ChooDH/DKRoA/연구자료/DKRoA 그림/DKRoA_구조.png

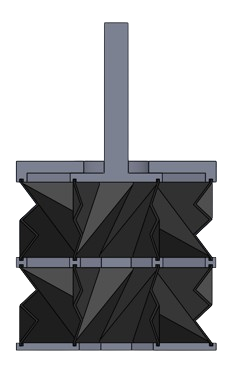
연구자료/DKRoA 그림/DKRoA_구조.png
