ChooDH/DKRoA/연구자료/DKRoA 그림/Inner_DKRoA.png

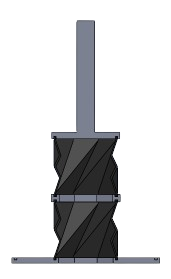
연구자료/DKRoA 그림/Inner_DKRoA.png
