ChooDH/DKRoA/연구자료/DKRoA 그림/Kresling_pattern.png

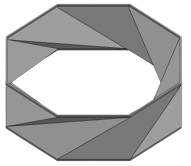
연구자료/DKRoA 그림/Kresling_pattern.png
