ChooDH/DKRoA/연구자료/DKRoA 그림/Kresling_pattern_folding.png

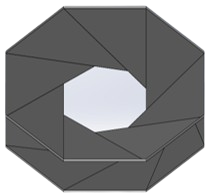
연구자료/DKRoA 그림/Kresling_pattern_folding.png
