ChooDH/DKRoA/연구자료/DKRoA 그림/Outer_DKRoA.png

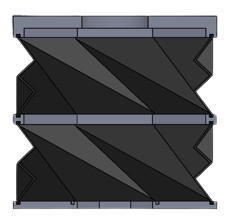
연구자료/DKRoA 그림/Outer_DKRoA.png
