ChooDH/DKRoA/연구자료/DKRoA 그림/그림7-removebg-preview.png

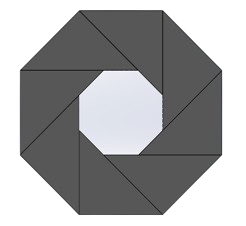
연구자료/DKRoA 그림/그림7-removebg-preview.png
