ChooDH/DKRoA/actuator_modeling/mechanical_seal/mechanical_seal_DKRoA.SLDASM

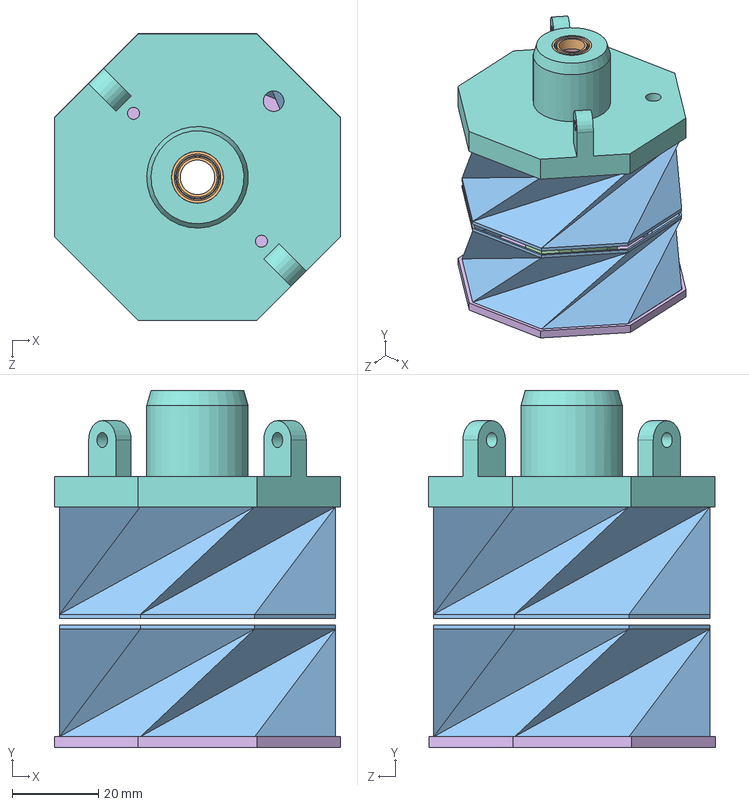
[picture p8: CAD file, 2024-12-23]
actuator_modeling/mechanical_seal/mechanical_seal_DKRoA.SLDASM
66.5 x 82.9 x 66.6 mm
outer_top_상판
outer_top_하판
bottom
MS_CeramicRing
inner_kresling_cw x 2
outer_kresling_cw x 2
bearing
spring
