ChooDH/DKRoA/actuator_modeling/magnetic_coupling/magnetic_10mm_3mm.SLDPRT

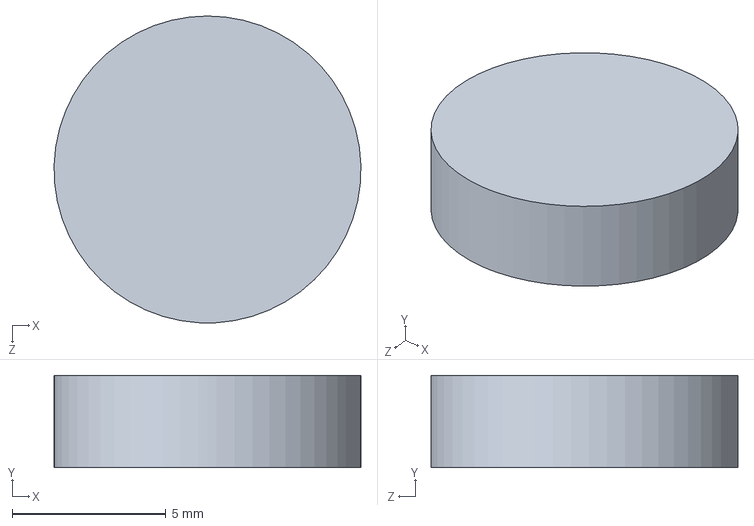
[picture p9: CAD file, 2024-12-23]
actuator_modeling/magnetic_coupling/magnetic_10mm_3mm.SLDPRT
10.00 x 3.00 x 10.0 mm
