ChooDH/DKRoA/actuator_modeling/opposite_direction/inner_top_opposite_direction.SLDPRT

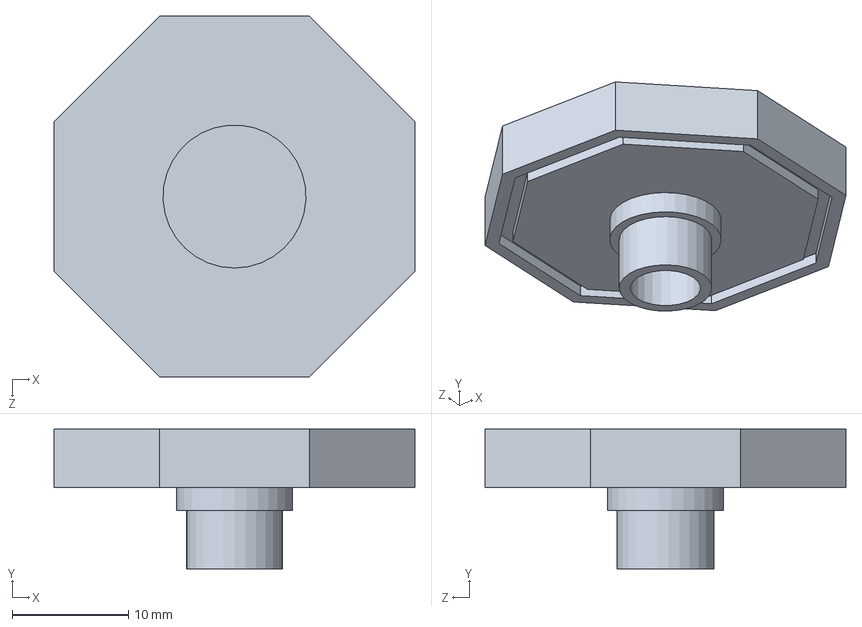
[picture p10: CAD file, 2024-12-23]
actuator_modeling/opposite_direction/inner_top_opposite_direction.SLDPRT
31.0 x 12.0 x 31.0 mm
