ChooDH/DKRoA/kresling_test/kresling test/kresling.SLDPRT

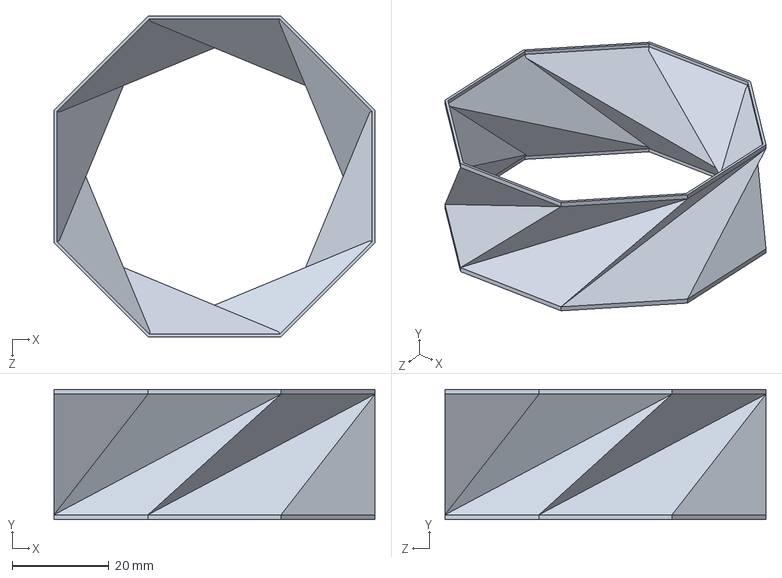
[picture p11: CAD file, 2024-12-23]
kresling_test/kresling test/kresling.SLDPRT
66.5 x 27.0 x 66.5 mm
