ChooDH/DKRoA/kresling_test/kresling test/test_stl/mode_test/kresling_mode_2_R_25_d_0.8.STL

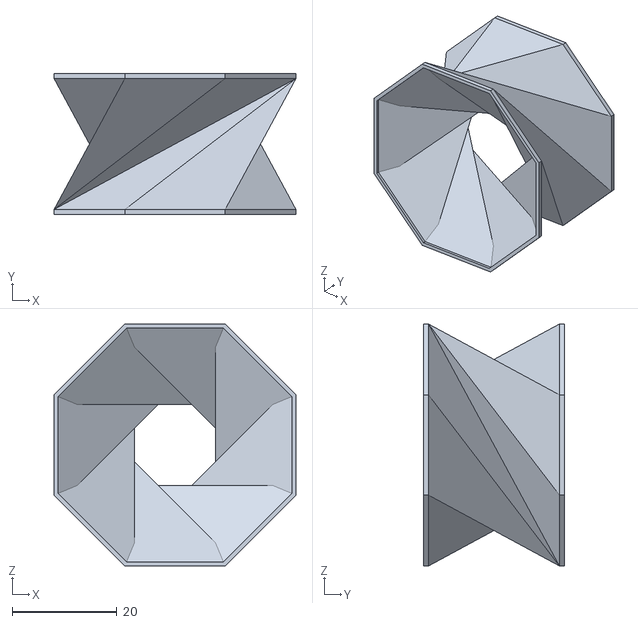
[picture p13: CAD file, 2024-12-23]
kresling_test/kresling test/test_stl/mode_test/kresling_mode_2_R_25_d_0.8.STL
46.2 x 27.0 x 46.2
