ChooDH/DKRoA/kresling_test/kresling test/test_stl/n_test/degree_test_top_n_6.STL

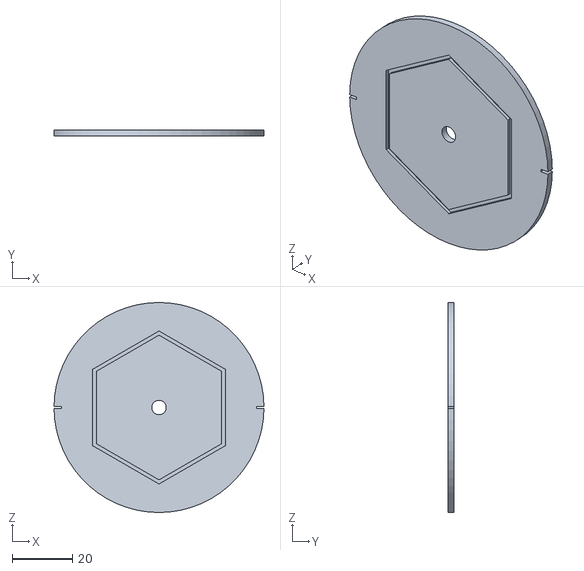
[picture p14: CAD file, 2024-12-23]
kresling_test/kresling test/test_stl/n_test/degree_test_top_n_6.STL
70.0 x 2.00 x 70.0
