ChooDH/DKRoA/kresling_test/kresling test/test_stl/outer_kresling_cw_71mm.STL

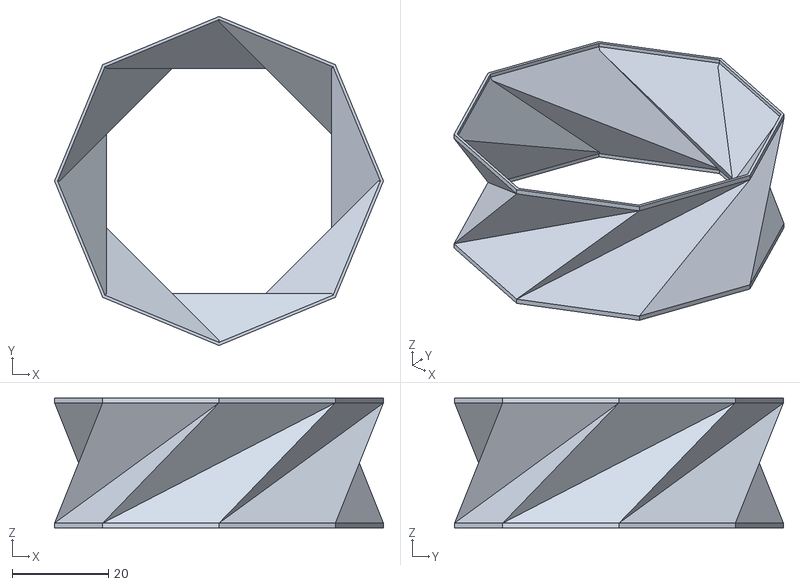
[picture p15: CAD file, 2024-12-23]
kresling_test/kresling test/test_stl/outer_kresling_cw_71mm.STL
68.4 x 68.4 x 27.0
