ChooDH/DKRoA/actuator_modeling/magnetic_coupling/inner_link_magnetic_coupling.SLDPRT

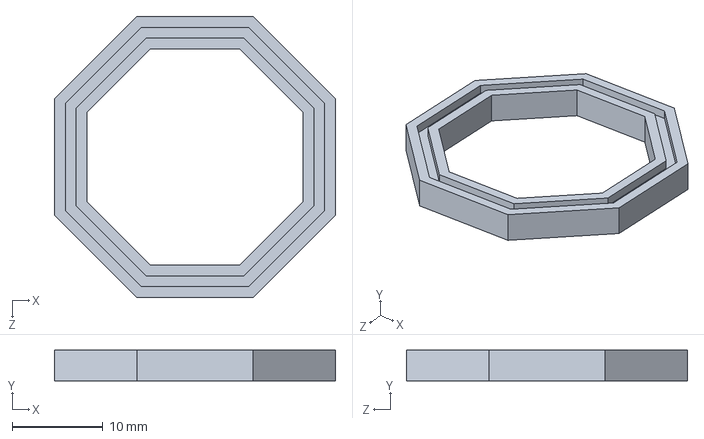
[picture p16: CAD file, 2024-12-23]
actuator_modeling/magnetic_coupling/inner_link_magnetic_coupling.SLDPRT
31.0 x 3.40 x 31.0 mm
