ChooDH/DKRoA/actuator_modeling/mechanical_seal/spring.SLDPRT

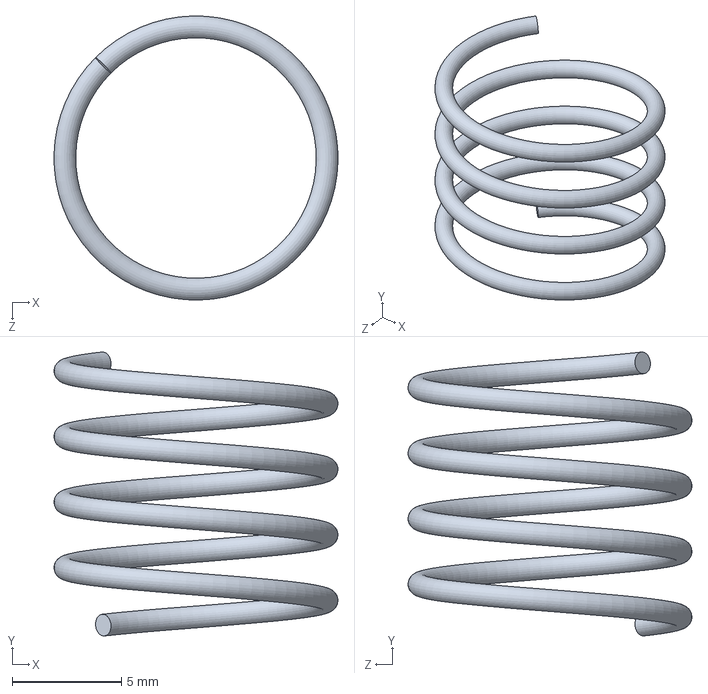
[picture p17: CAD file, 2024-12-23]
actuator_modeling/mechanical_seal/spring.SLDPRT
13.0 x 13.0 x 13.0 mm
