ChooDH/DKRoA/actuator_modeling/opposite_direction/plus_link_opposite_direction.SLDPRT

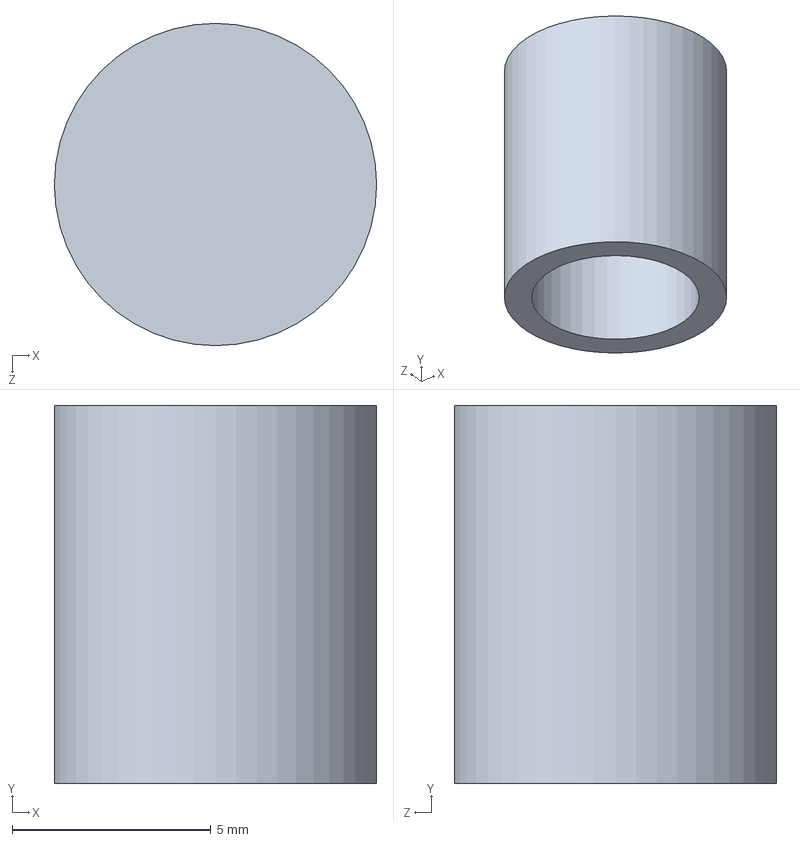
[picture p18: CAD file, 2024-12-23]
actuator_modeling/opposite_direction/plus_link_opposite_direction.SLDPRT
8.10 x 9.50 x 8.10 mm
