ChooDH/DKRoA/kresling_test/kresling test/degree_test_top.SLDPRT

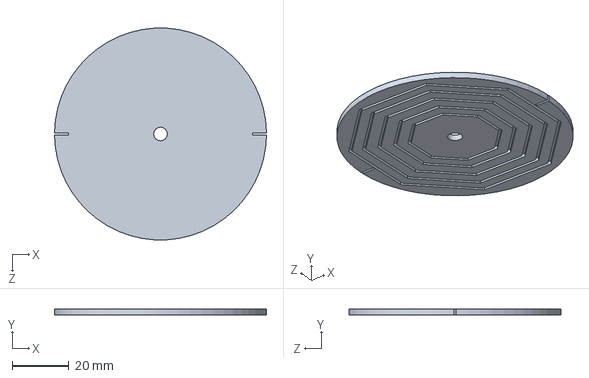
[picture p19: CAD file, 2024-12-23]
kresling_test/kresling test/degree_test_top.SLDPRT
75.0 x 2.00 x 74.9 mm
