ChooDH/DKRoA/kresling_test/kresling test/test_stl/D_test/kresling_R_20.STL

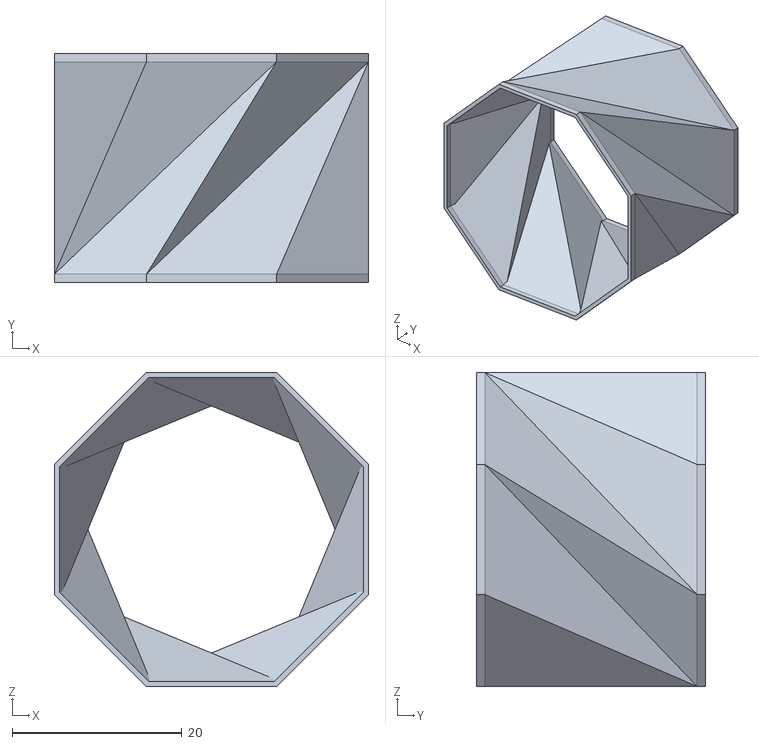
[picture p20: CAD file, 2024-12-23]
kresling_test/kresling test/test_stl/D_test/kresling_R_20.STL
37.0 x 27.0 x 37.0
