ChooDH/DKRoA/kresling_test/kresling test/test_stl/degree_test_top_2.STL

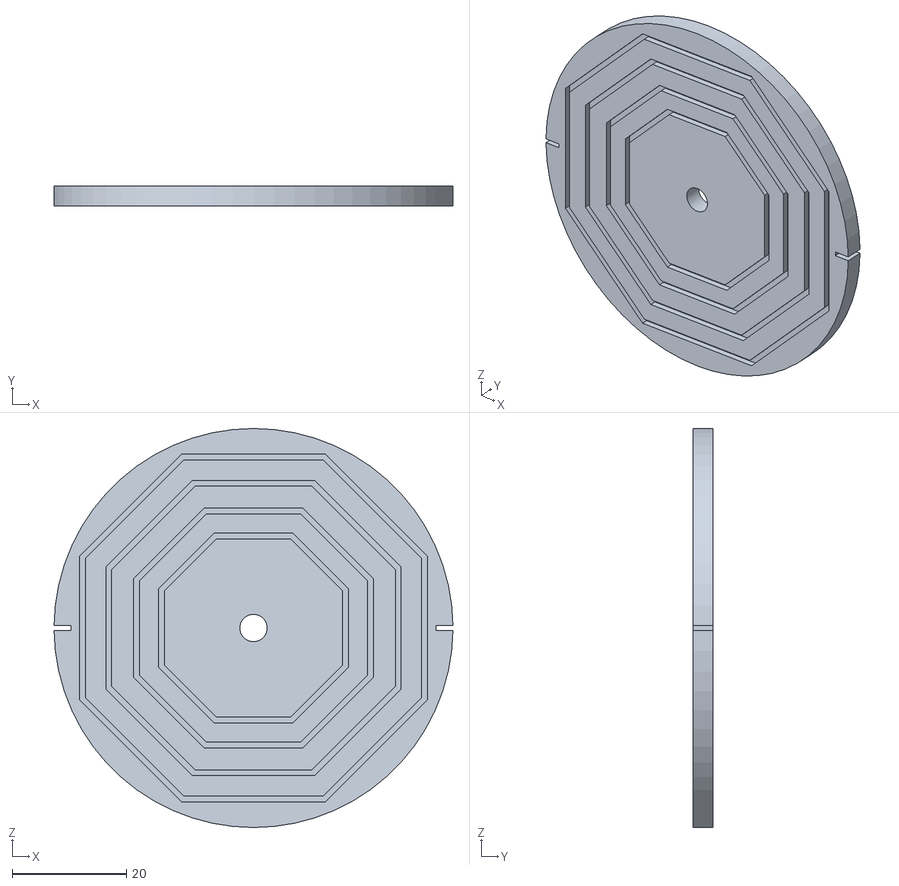
[picture p21: CAD file, 2024-12-23]
kresling_test/kresling test/test_stl/degree_test_top_2.STL
70.0 x 3.50 x 70.0
