ChooDH/DKRoA/kresling_test/kresling test/test_stl/mode_test/kresling_mode_2_R_30_d_1.STL

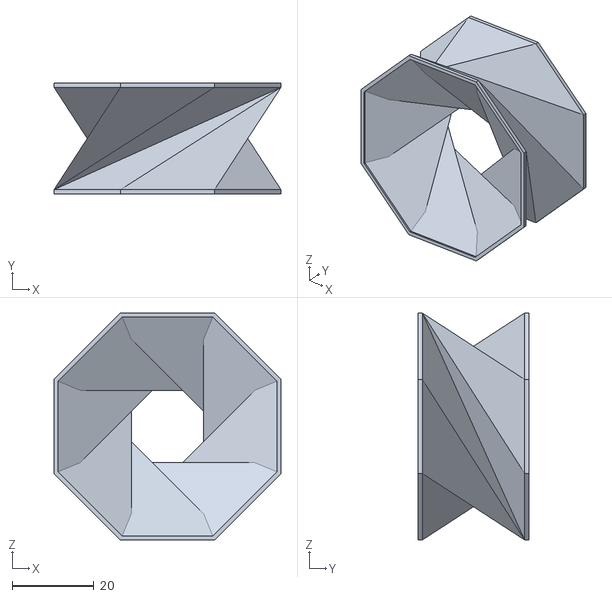
[picture p22: CAD file, 2024-12-23]
kresling_test/kresling test/test_stl/mode_test/kresling_mode_2_R_30_d_1.STL
55.4 x 27.0 x 55.4
