ChooDH/DKRoA/actuator_modeling/magnetic_coupling/bottom_magnetic_coupling.SLDPRT

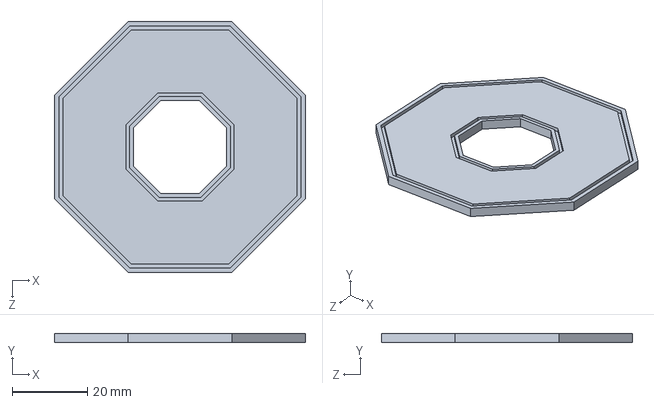
[picture p23: CAD file, 2024-12-23]
actuator_modeling/magnetic_coupling/bottom_magnetic_coupling.SLDPRT
66.5 x 2.50 x 66.5 mm
