ChooDH/DKRoA/actuator_modeling/mechanical_seal/outer_top_하판.SLDPRT

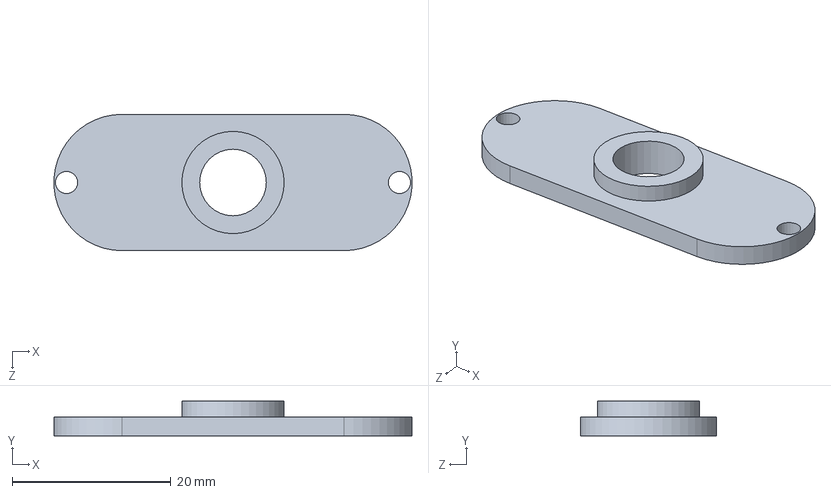
[picture p24: CAD file, 2024-12-23]
actuator_modeling/mechanical_seal/outer_top_하판.SLDPRT
45.2 x 4.40 x 17.2 mm
