ChooDH/DKRoA/actuator_modeling/opposite_direction/bottom_opposite_direction.SLDPRT

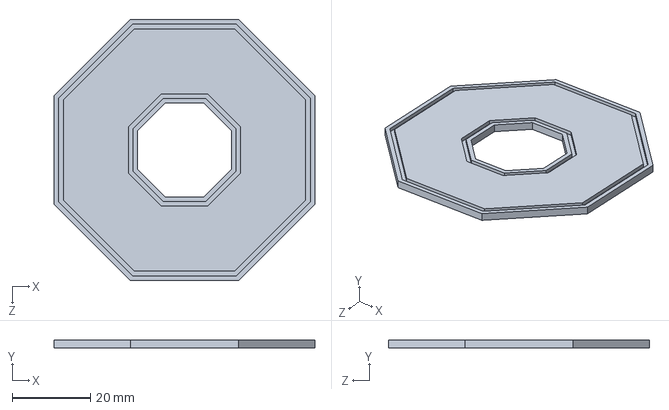
[picture p25: CAD file, 2024-12-23]
actuator_modeling/opposite_direction/bottom_opposite_direction.SLDPRT
66.5 x 2.00 x 66.5 mm
