ChooDH/DKRoA/kresling_test/kresling test/kresling_n__12_mode_4.SLDPRT

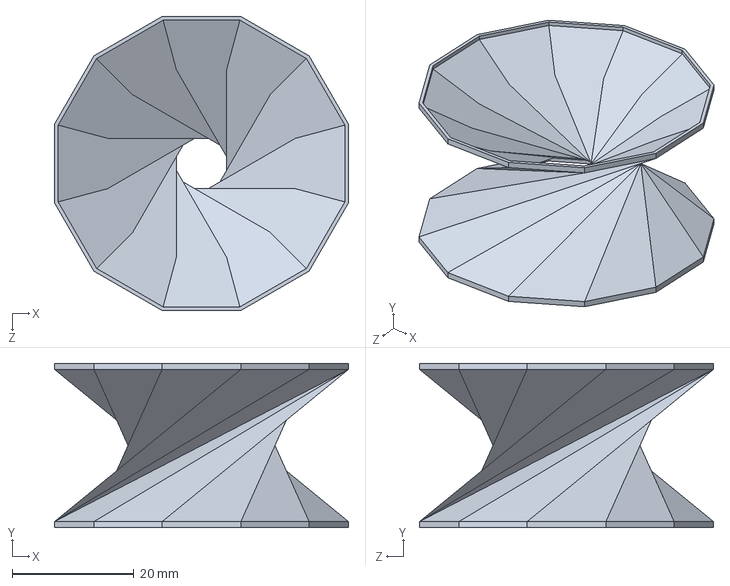
[picture p26: CAD file, 2024-12-23]
kresling_test/kresling test/kresling_n__12_mode_4.SLDPRT
48.3 x 27.0 x 48.3 mm
