ChooDH/DKRoA/kresling_test/kresling test/test_stl/D_test/kresling_R_25.STL

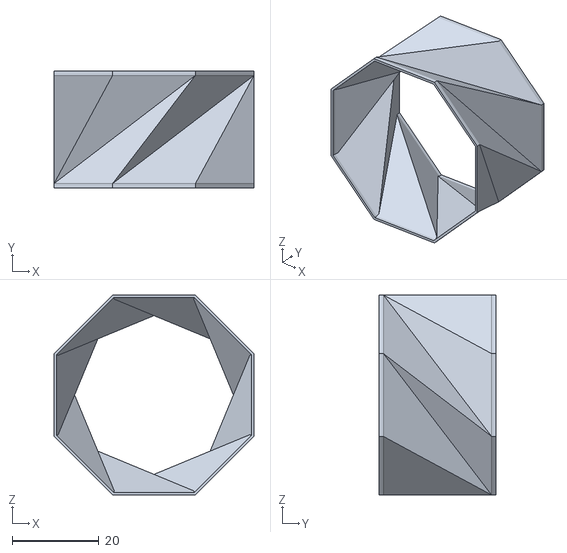
[picture p27: CAD file, 2024-12-23]
kresling_test/kresling test/test_stl/D_test/kresling_R_25.STL
46.2 x 27.0 x 46.2
