ChooDH/DKRoA/kresling_test/kresling test/test_stl/degree_test.STL

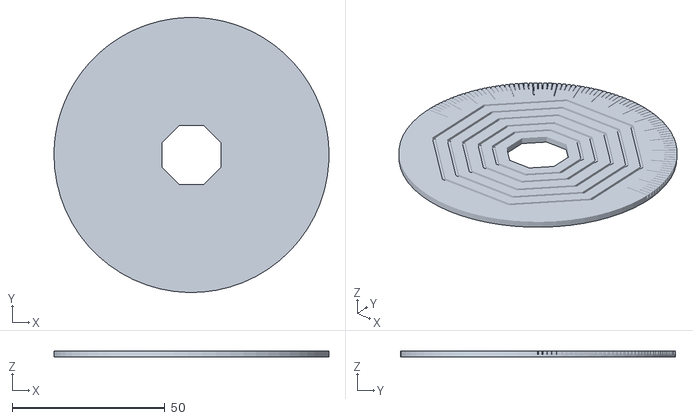
[picture p28: CAD file, 2024-12-23]
kresling_test/kresling test/test_stl/degree_test.STL
90.0 x 90.0 x 2.00
