ChooDH/DKRoA/kresling_test/kresling test/test_stl/mode_test/kresling_mode_2_R_35_d_1.STL

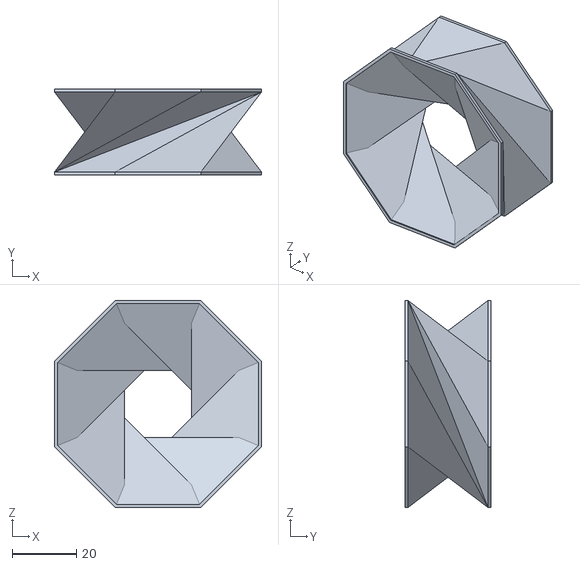
[picture p29: CAD file, 2024-12-23]
kresling_test/kresling test/test_stl/mode_test/kresling_mode_2_R_35_d_1.STL
64.7 x 27.0 x 64.7
