ChooDH/DKRoA/kresling_test/kresling test/test_stl/n_test/kresling_n_10.STL

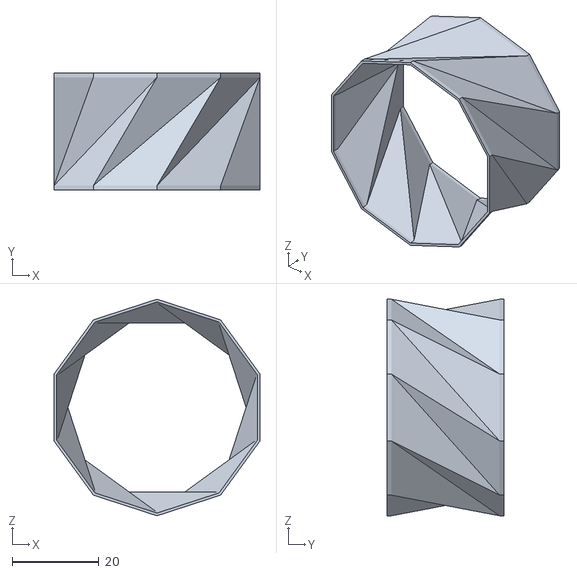
[picture p30: CAD file, 2024-12-23]
kresling_test/kresling test/test_stl/n_test/kresling_n_10.STL
47.6 x 27.0 x 50.0
