ChooDH/DKRoA/actuator_modeling/magnetic_coupling/outer_top_magnetic_coupling.SLDPRT

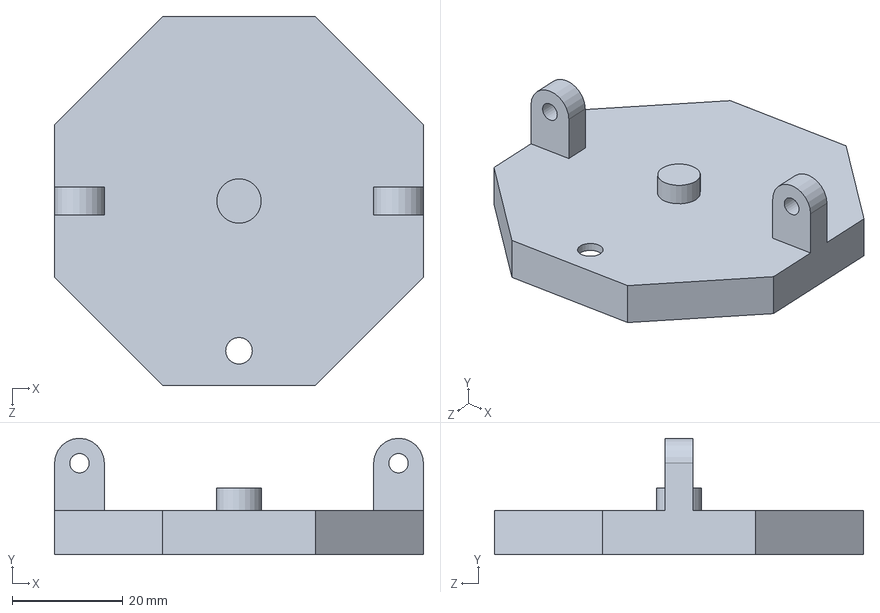
[picture p31: CAD file, 2024-12-23]
actuator_modeling/magnetic_coupling/outer_top_magnetic_coupling.SLDPRT
66.5 x 21.0 x 66.5 mm
