ChooDH/DKRoA/kresling_test/kresling test/kresling_mode_2.SLDPRT

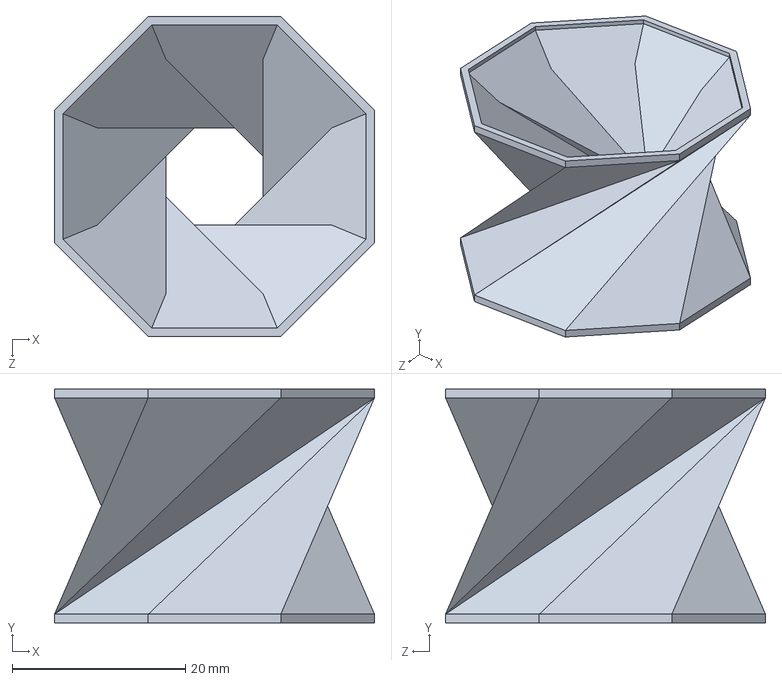
[picture p32: CAD file, 2024-12-23]
kresling_test/kresling test/kresling_mode_2.SLDPRT
37.0 x 27.0 x 37.0 mm
