ChooDH/DKRoA/kresling_test/kresling test/test_stl/D_test/kresling_R_22.5.STL

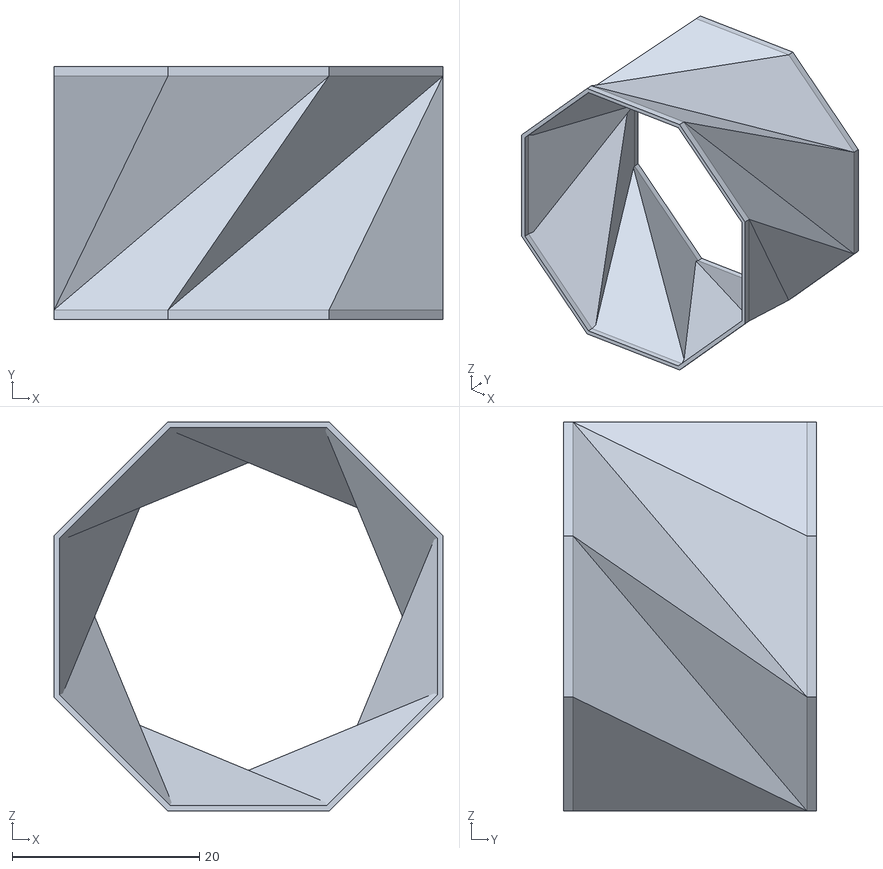
[picture p33: CAD file, 2024-12-23]
kresling_test/kresling test/test_stl/D_test/kresling_R_22.5.STL
41.6 x 27.0 x 41.6
