ChooDH/DKRoA/kresling_test/kresling test/test_stl/degree_test_2.STL

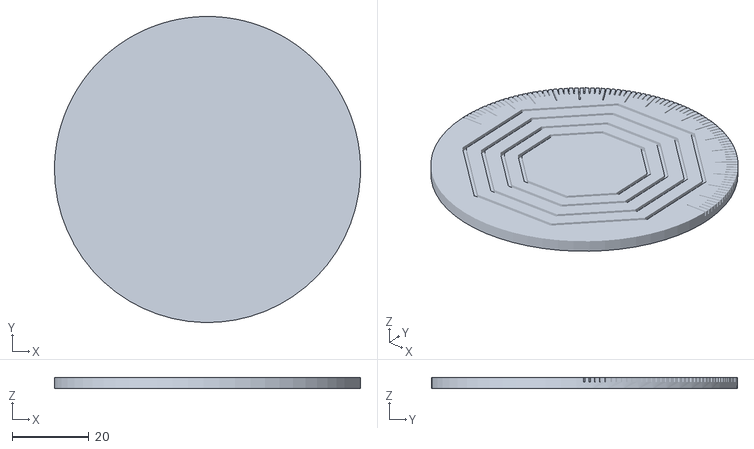
[picture p34: CAD file, 2024-12-23]
kresling_test/kresling test/test_stl/degree_test_2.STL
80.0 x 80.0 x 3.00
