ChooDH/DKRoA/kresling_test/kresling test/test_stl/n_test/degree_test_n_10.STL

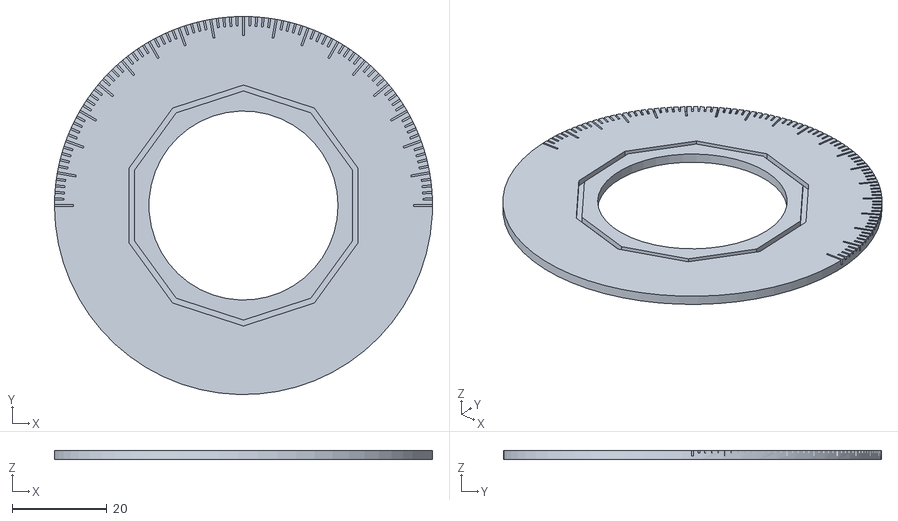
[picture p36: CAD file, 2024-12-23]
kresling_test/kresling test/test_stl/n_test/degree_test_n_10.STL
80.0 x 80.0 x 2.00
