ChooDH/DKRoA/actuator_modeling/magnetic_coupling/magnetic_coupling_axis_down.SLDPRT

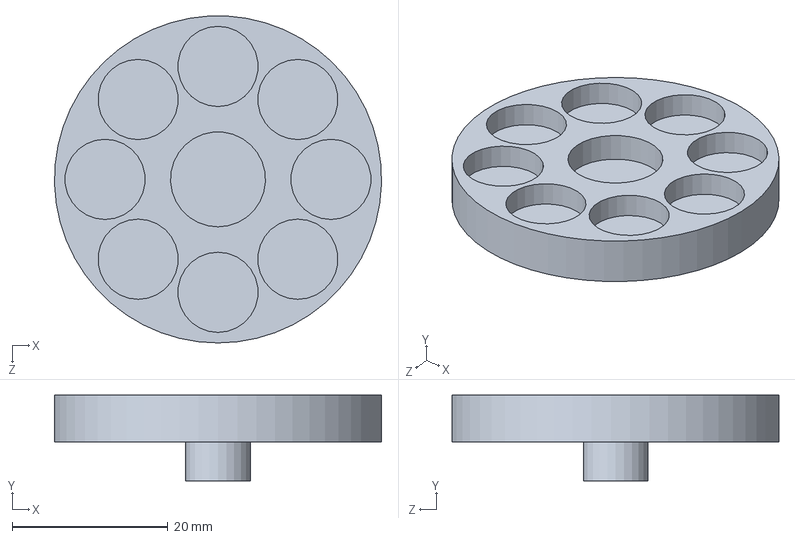
[picture p37: CAD file, 2024-12-23]
actuator_modeling/magnetic_coupling/magnetic_coupling_axis_down.SLDPRT
42.0 x 11.0 x 42.0 mm
