ChooDH/DKRoA/actuator_modeling/mechanical_seal/outer_top_상판.SLDPRT

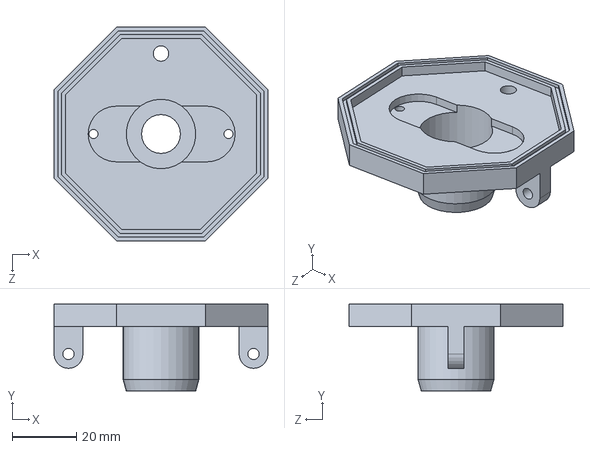
[picture p38: CAD file, 2024-12-23]
actuator_modeling/mechanical_seal/outer_top_상판.SLDPRT
66.5 x 27.0 x 66.5 mm
