ChooDH/DKRoA/actuator_modeling/opposite_direction/outer_top_opposite_direction.SLDPRT

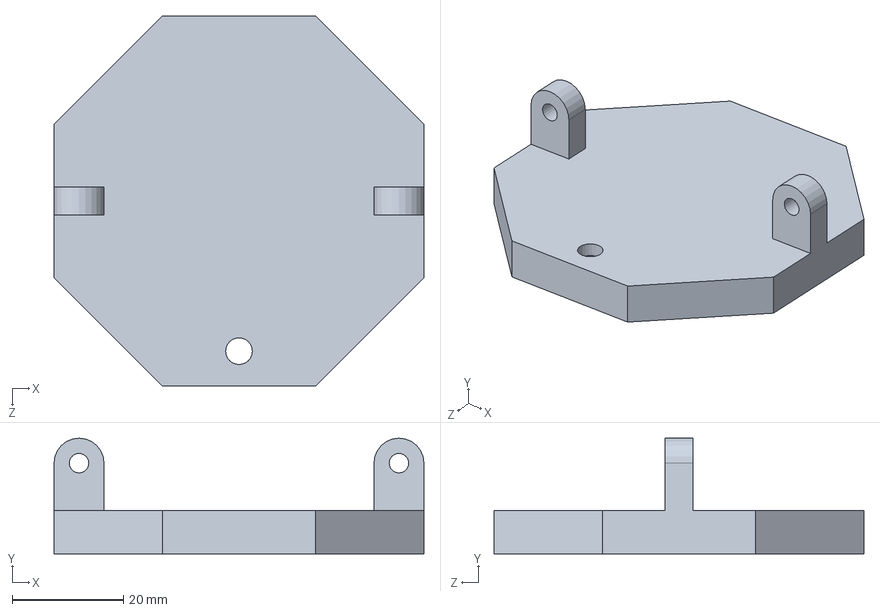
[picture p39: CAD file, 2024-12-23]
actuator_modeling/opposite_direction/outer_top_opposite_direction.SLDPRT
66.5 x 20.8 x 66.5 mm
