ChooDH/DKRoA/kresling_test/kresling test/test_stl/D_test/kresling_R_32.5.STL

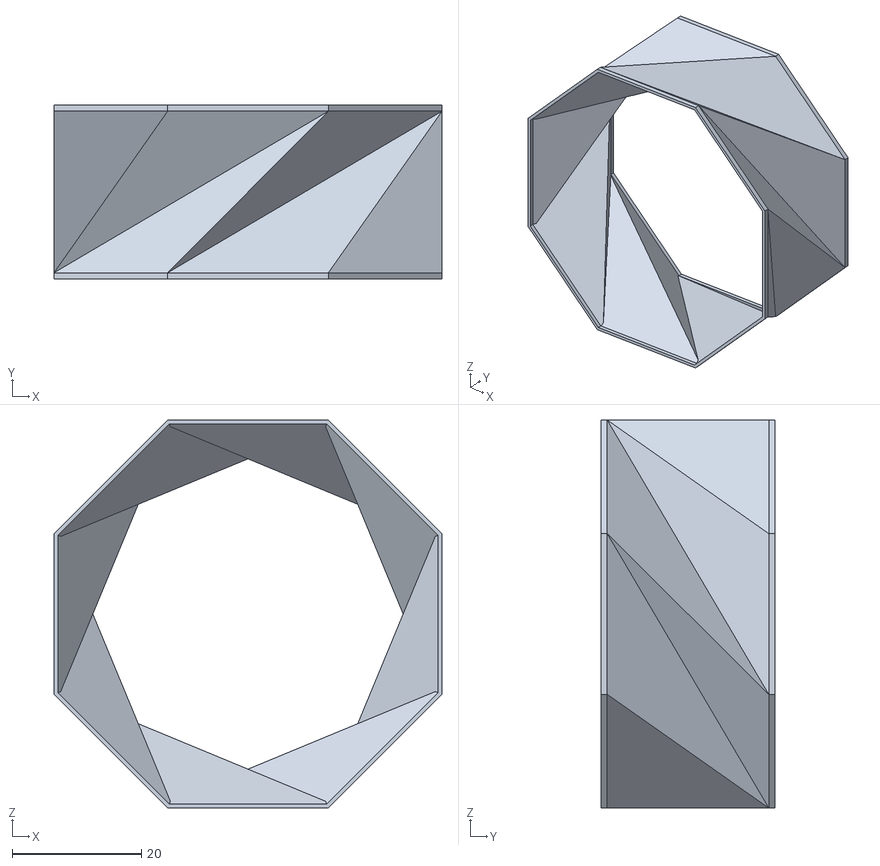
[picture p40: CAD file, 2024-12-23]
kresling_test/kresling test/test_stl/D_test/kresling_R_32.5.STL
60.1 x 27.0 x 60.1
