ChooDH/DKRoA/kresling_test/kresling test/test_stl/mode_test/kresling_mode_2_R_25.STL

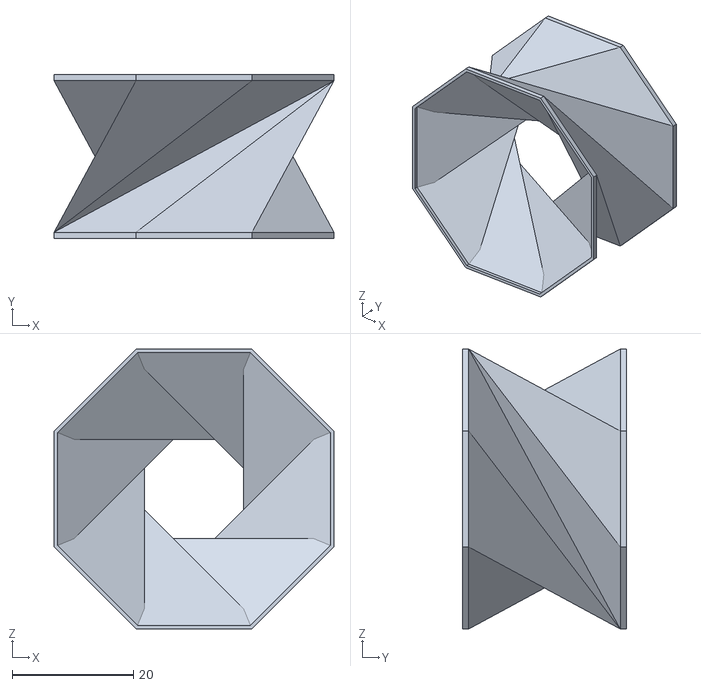
[picture p41: CAD file, 2024-12-23]
kresling_test/kresling test/test_stl/mode_test/kresling_mode_2_R_25.STL
46.2 x 27.0 x 46.2
