ChooDH/DKRoA/kresling_test/kresling test/test_stl/n_test/degree_n_test_R35.STL

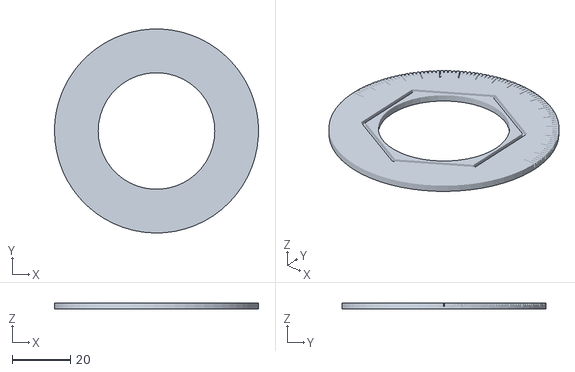
[picture p42: CAD file, 2024-12-23]
kresling_test/kresling test/test_stl/n_test/degree_n_test_R35.STL
70.0 x 70.0 x 2.00
