ChooDH/DKRoA/actuator_modeling/magnetic_coupling/magnetic_coupling_axis_up.SLDPRT

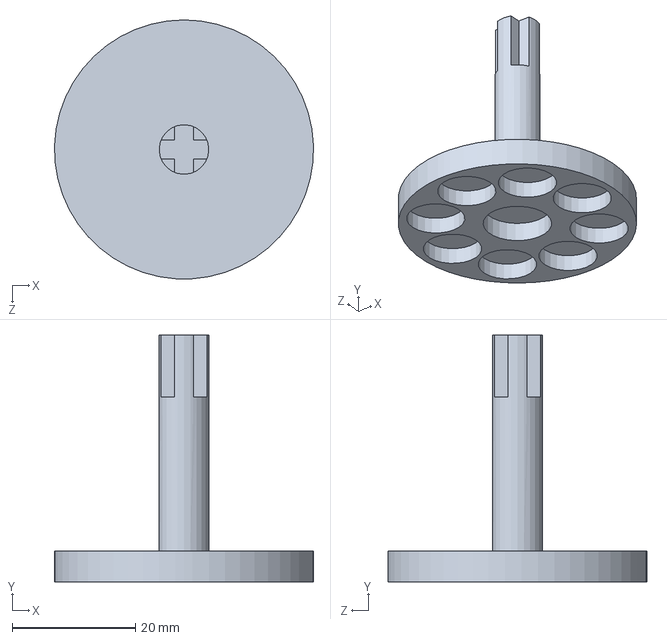
[picture p43: CAD file, 2024-12-23]
actuator_modeling/magnetic_coupling/magnetic_coupling_axis_up.SLDPRT
42.0 x 40.0 x 42.0 mm
