ChooDH/DKRoA/actuator_modeling/mechanical_seal/MS_CeramicRing.SLDPRT

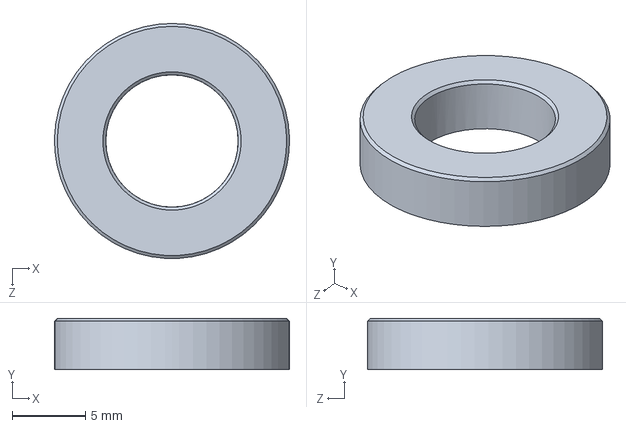
[picture p44: CAD file, 2024-12-23]
actuator_modeling/mechanical_seal/MS_CeramicRing.SLDPRT
16.0 x 3.50 x 16.0 mm
