ChooDH/DKRoA/actuator_modeling/opposite_direction/outer_kresling_cw_opposite_direction.SLDPRT

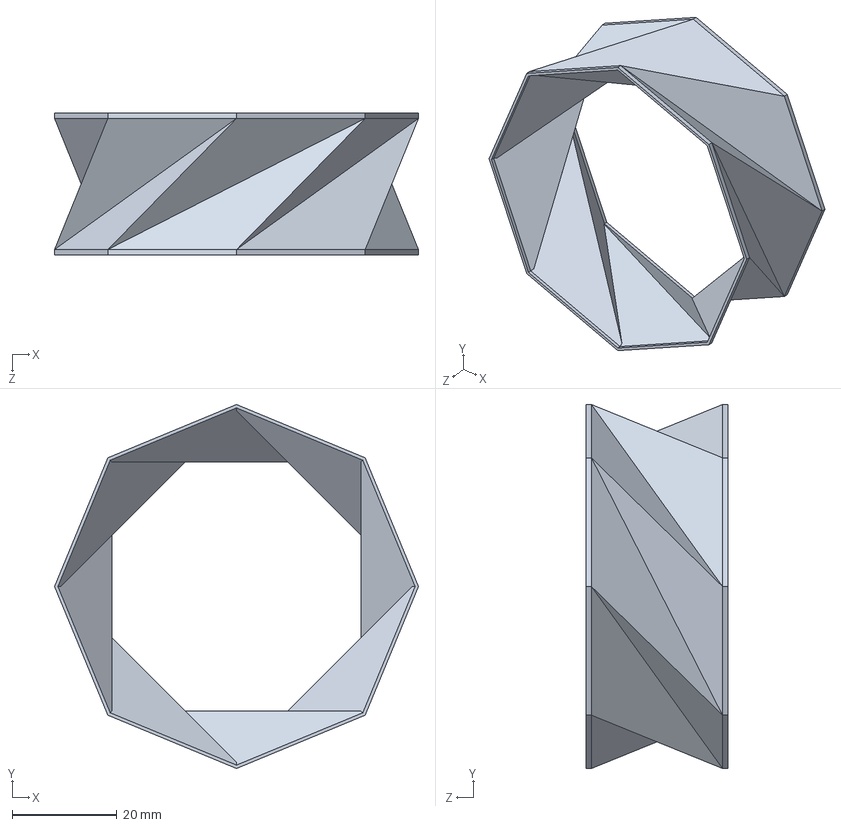
[picture p45: CAD file, 2024-12-23]
actuator_modeling/opposite_direction/outer_kresling_cw_opposite_direction.SLDPRT
69.4 x 69.4 x 27.0 mm
