ChooDH/DKRoA/kresling_test/kresling test/kresling_n_16.SLDPRT

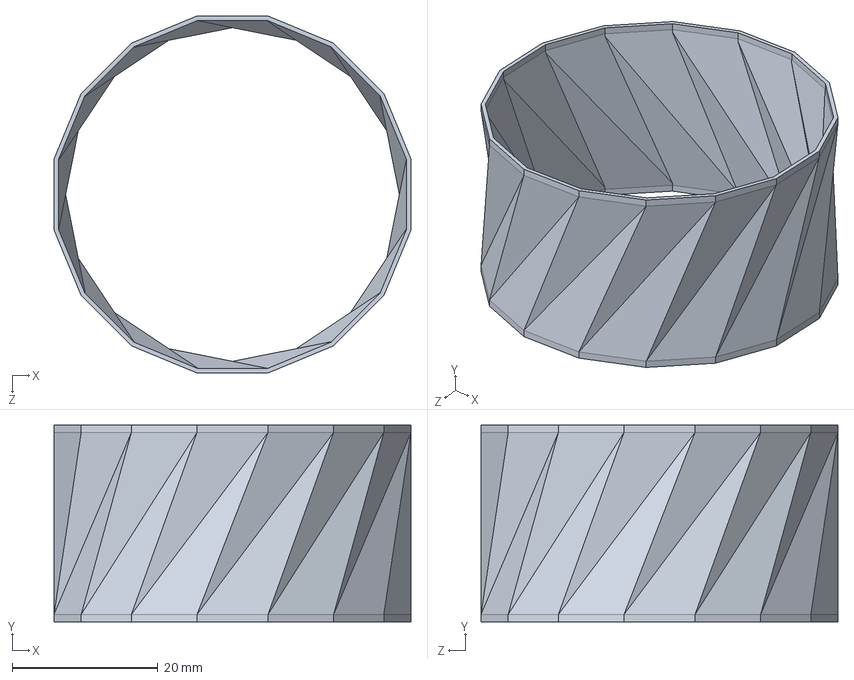
[picture p46: CAD file, 2024-12-23]
kresling_test/kresling test/kresling_n_16.SLDPRT
49.0 x 27.0 x 49.0 mm
