ChooDH/DKRoA/kresling_test/kresling test/test_stl/D_test/kresling_R_27.5.STL

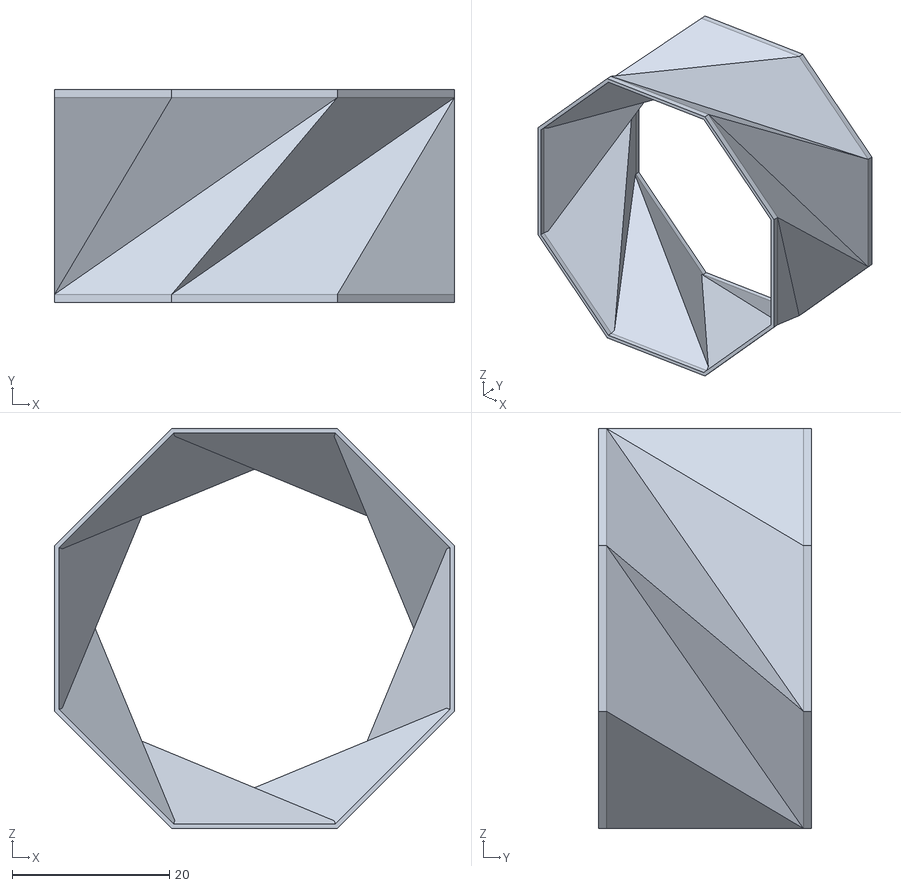
[picture p47: CAD file, 2024-12-23]
kresling_test/kresling test/test_stl/D_test/kresling_R_27.5.STL
50.8 x 27.0 x 50.8
