ChooDH/DKRoA/kresling_test/kresling test/test_stl/mode_test/kresling_mode_2_15.STL

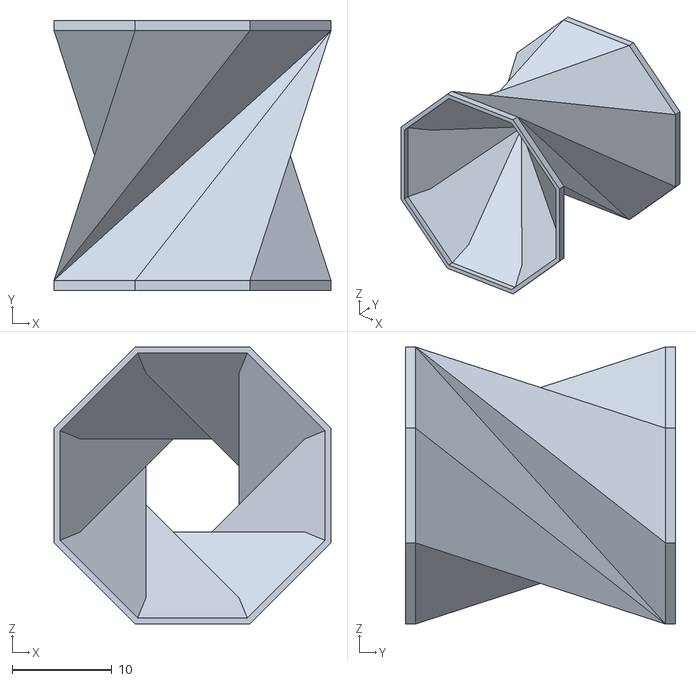
[picture p48: CAD file, 2024-12-23]
kresling_test/kresling test/test_stl/mode_test/kresling_mode_2_15.STL
27.7 x 27.0 x 27.7
