ChooDH/DKRoA/kresling_test/kresling test/test_stl/n_test/kresling_n_6.STL

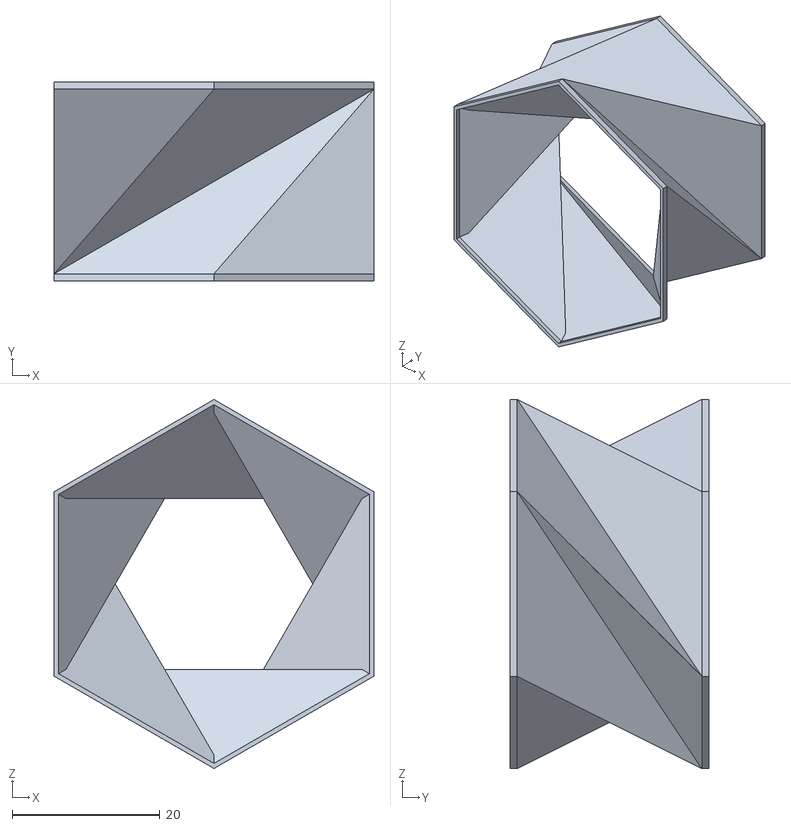
[picture p49: CAD file, 2024-12-23]
kresling_test/kresling test/test_stl/n_test/kresling_n_6.STL
43.3 x 27.0 x 50.0
