ChooDH/DKRoA/actuator_modeling/magnetic_coupling/outer_link_magnetic_coupling.SLDPRT

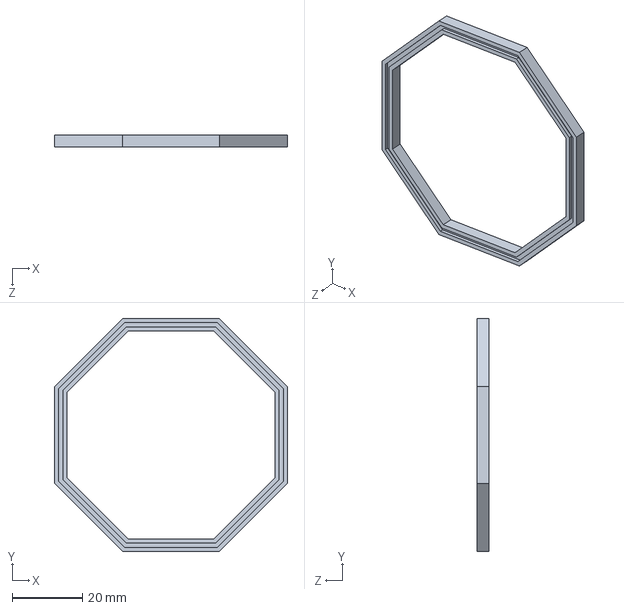
[picture p50: CAD file, 2024-12-23]
actuator_modeling/magnetic_coupling/outer_link_magnetic_coupling.SLDPRT
66.5 x 66.5 x 3.40 mm
