ChooDH/DKRoA/kresling_test/kresling test/test_stl/D_test/kresling_R_17.5.STL

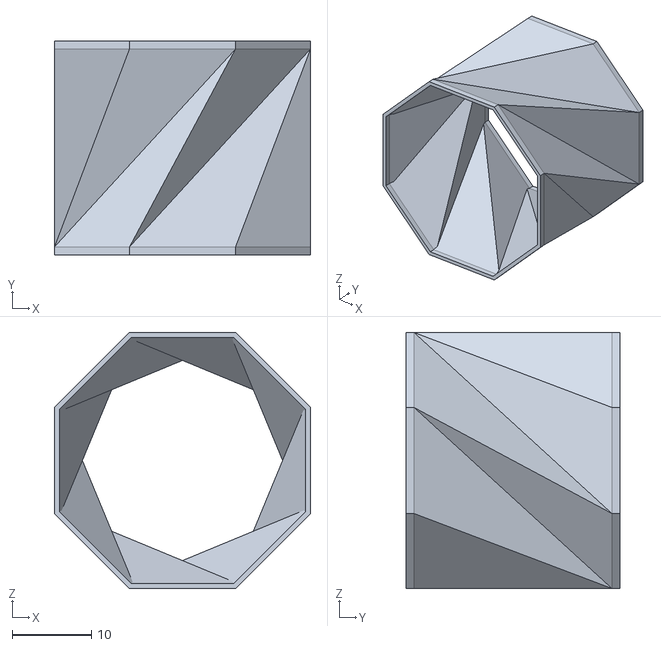
[picture p51: CAD file, 2024-12-23]
kresling_test/kresling test/test_stl/D_test/kresling_R_17.5.STL
32.3 x 27.0 x 32.3
