ChooDH/DKRoA/kresling_test/kresling test/test_stl/mode_test/kresling_n__12_mode_3.STL

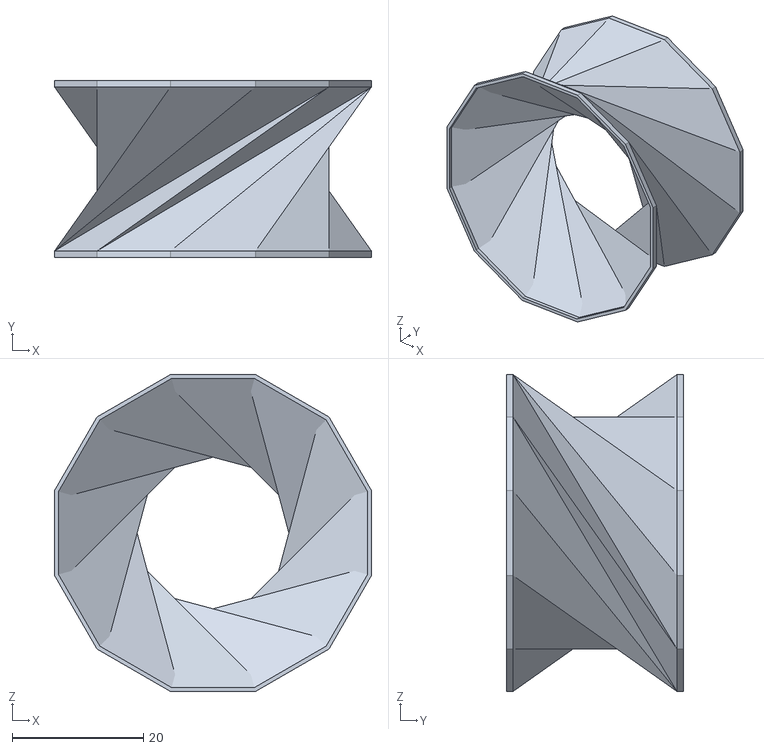
[picture p52: CAD file, 2024-12-23]
kresling_test/kresling test/test_stl/mode_test/kresling_n__12_mode_3.STL
48.3 x 27.0 x 48.3
