ChooDH/DKRoA/actuator_modeling/opposite_direction/inner_kresling_cw_opposite_direction.SLDPRT

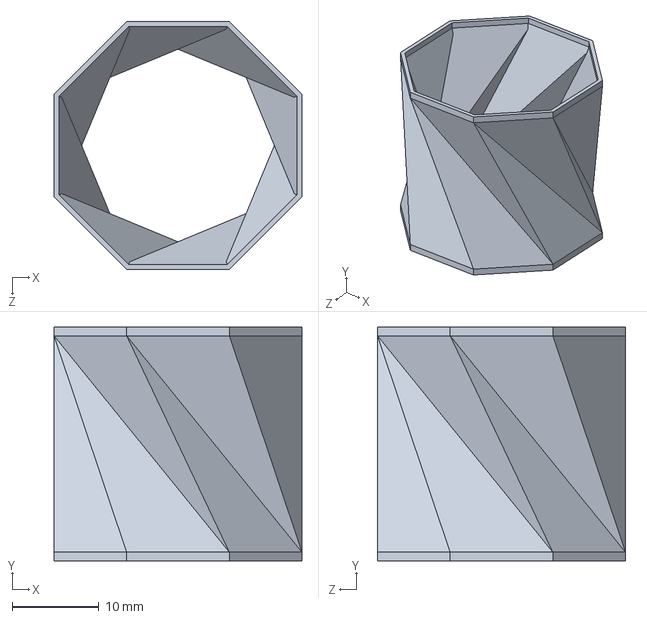
[picture p53: CAD file, 2024-12-23]
actuator_modeling/opposite_direction/inner_kresling_cw_opposite_direction.SLDPRT
28.6 x 27.0 x 28.6 mm
