ChooDH/DKRoA/kresling_test/kresling test/test_stl/D_test/kresling_R_30.STL

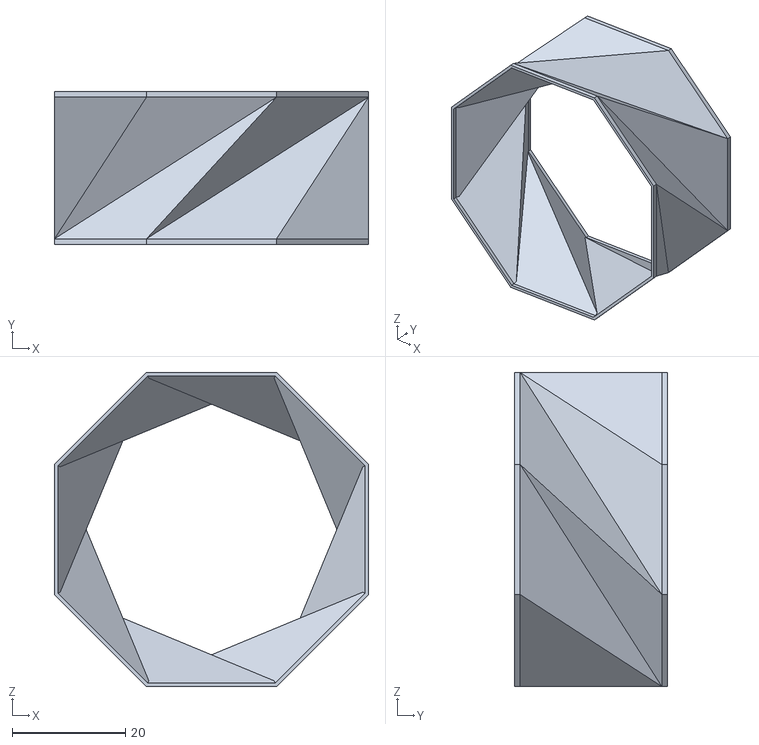
[picture p54: CAD file, 2024-12-23]
kresling_test/kresling test/test_stl/D_test/kresling_R_30.STL
55.4 x 27.0 x 55.4
