ChooDH/DKRoA/kresling_test/kresling test/test_stl/n_test/kresling_n_14.STL

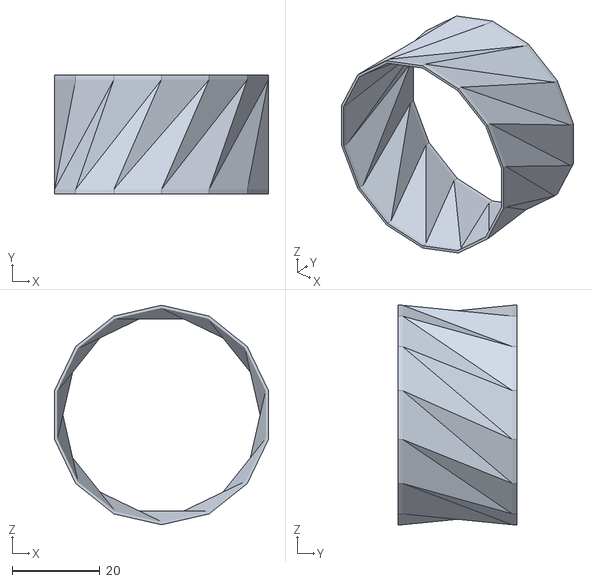
[picture p55: CAD file, 2024-12-23]
kresling_test/kresling test/test_stl/n_test/kresling_n_14.STL
48.7 x 27.0 x 50.0
