ChooDH/DKRoA/actuator_modeling/mechanical_seal/inner_top_mechanical_seal.SLDPRT

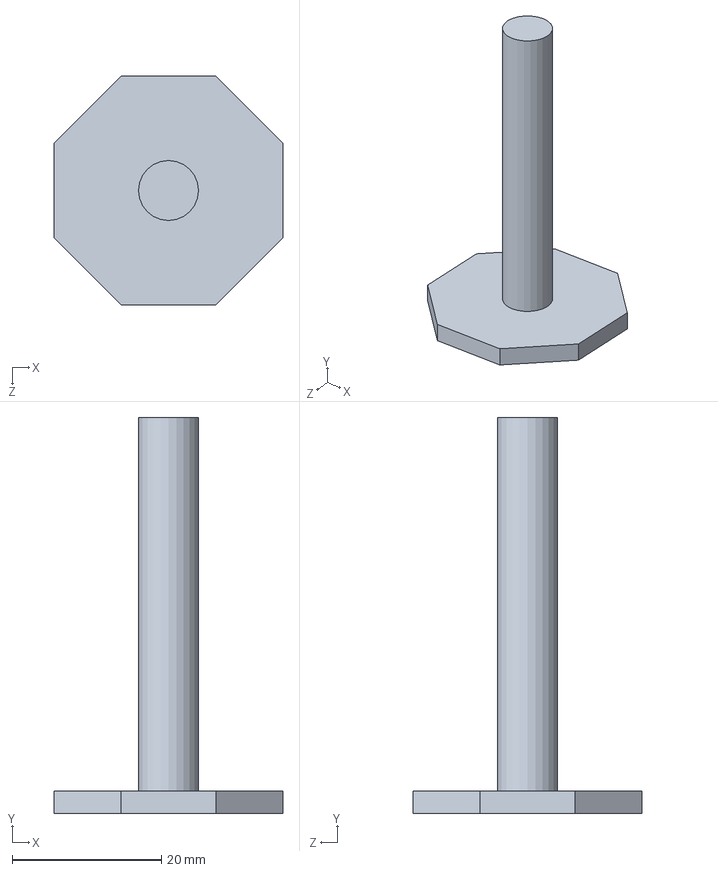
[picture p56: CAD file, 2024-12-23]
actuator_modeling/mechanical_seal/inner_top_mechanical_seal.SLDPRT
30.6 x 53.0 x 30.6 mm
