ChooDH/DKRoA/kresling_test/kresling test/test_stl/D_test/kresling_R_10.STL

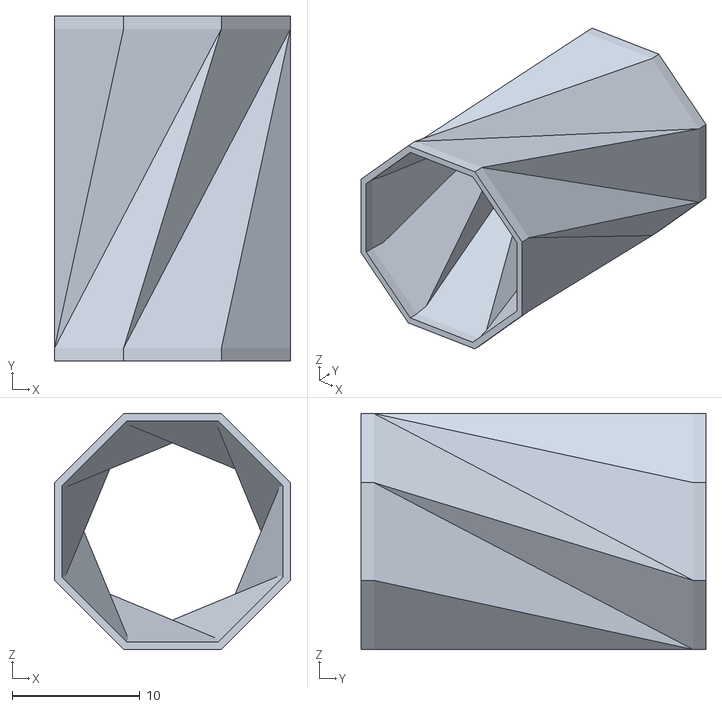
[picture p57: CAD file, 2024-12-23]
kresling_test/kresling test/test_stl/D_test/kresling_R_10.STL
18.5 x 27.0 x 18.5
