ChooDH/DKRoA/actuator_modeling/opposite_direction/bar_R_5_70mm.SLDPRT

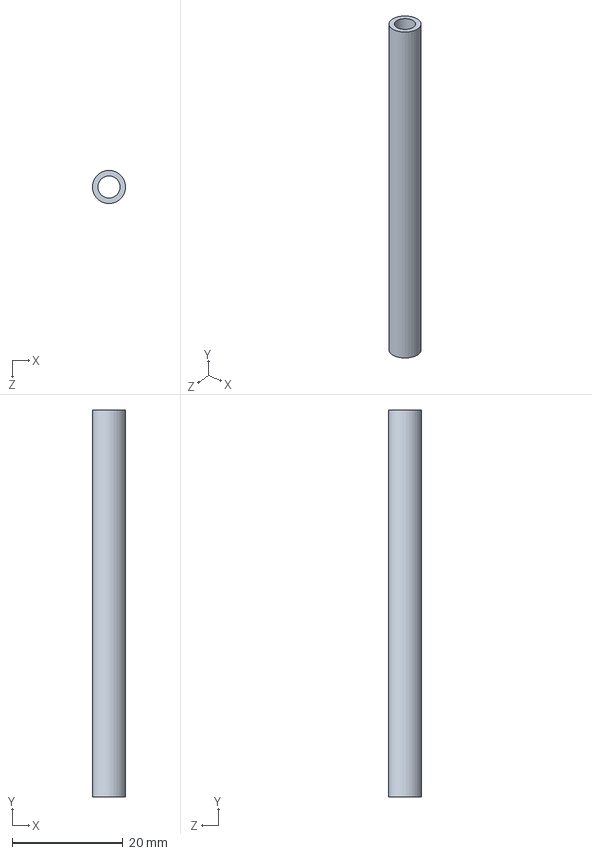
[picture p59: CAD file, 2024-12-23]
actuator_modeling/opposite_direction/bar_R_5_70mm.SLDPRT
5.99 x 70.0 x 6.00 mm
