ChooDH/DKRoA/kresling_test/kresling test/test_stl/D_test/kresling_R_35.STL

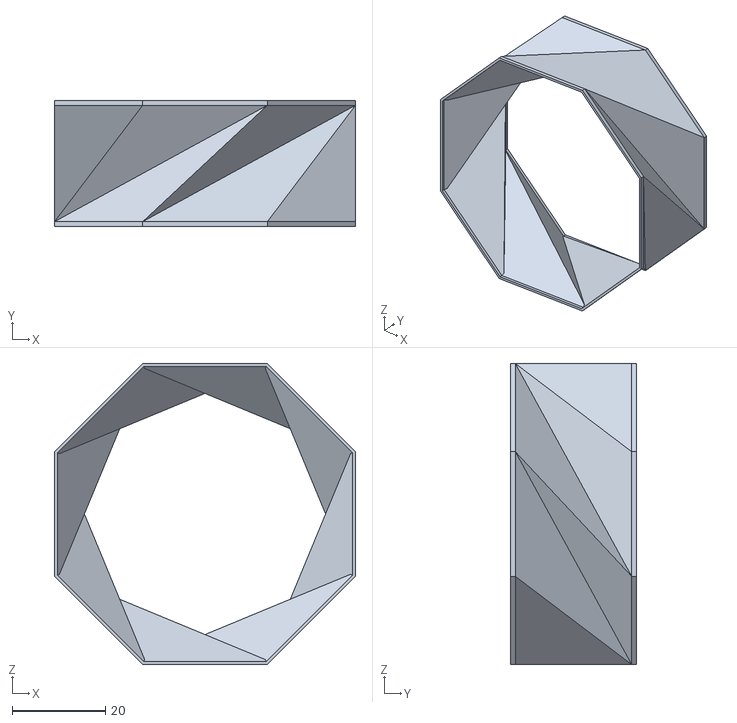
[picture p60: CAD file, 2024-12-23]
kresling_test/kresling test/test_stl/D_test/kresling_R_35.STL
64.7 x 27.0 x 64.7
