ChooDH/DKRoA/actuator_modeling/mechanical_seal/bearing.SLDPRT

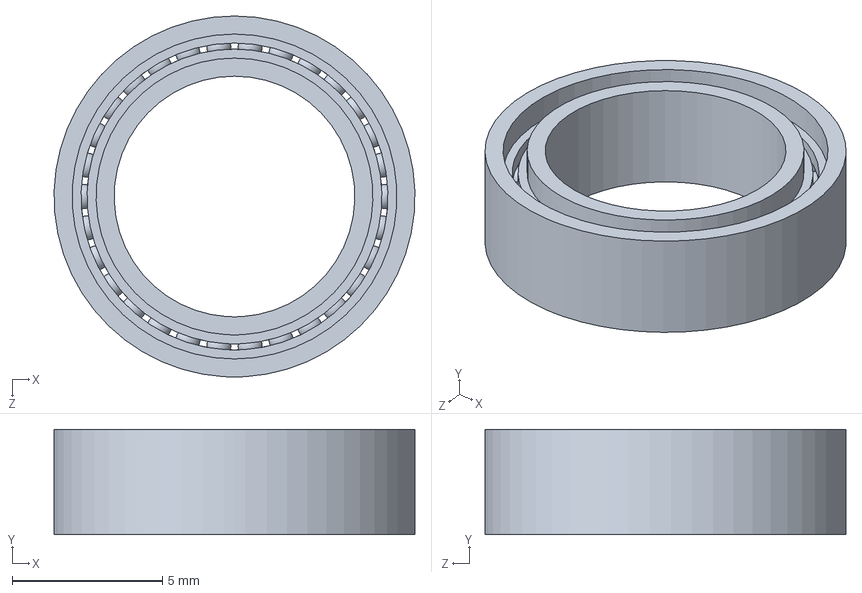
[picture p61: CAD file, 2024-12-23]
actuator_modeling/mechanical_seal/bearing.SLDPRT
12.0 x 3.50 x 12.0 mm
