ChooDH/DKRoA/kresling_test/kresling test/kresling_n_12.SLDPRT

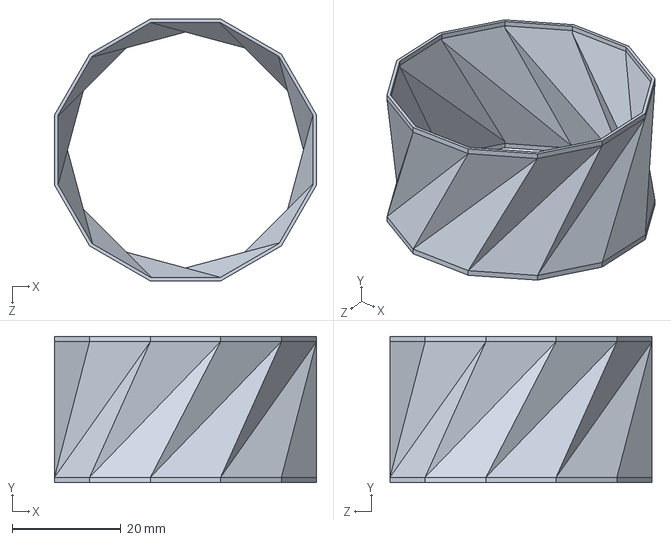
[picture p62: CAD file, 2024-12-23]
kresling_test/kresling test/kresling_n_12.SLDPRT
48.3 x 27.0 x 48.3 mm
