ChooDH/DKRoA/kresling_test/kresling test/kresling._mode2SLDPRT.SLDPRT

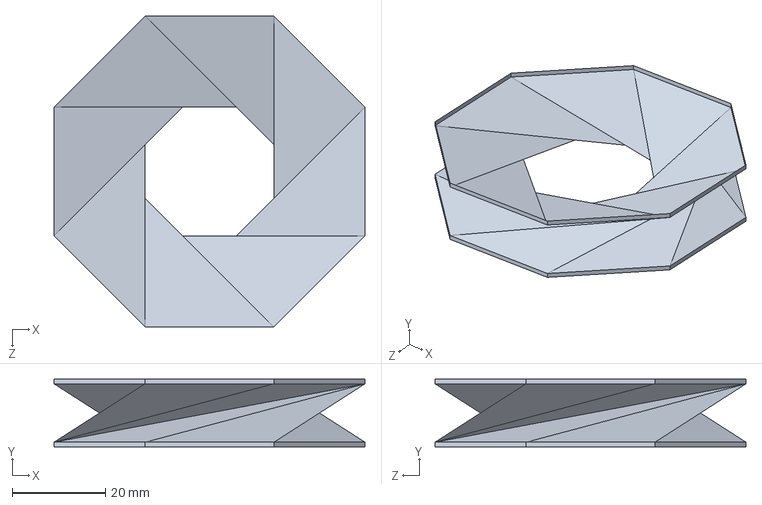
[picture p63: CAD file, 2024-12-23]
kresling_test/kresling test/kresling._mode2SLDPRT.SLDPRT
66.5 x 14.5 x 66.5 mm
