ChooDH/DKRoA/actuator_modeling/opposite_direction/Opposite_direction_DKRA.SLDASM

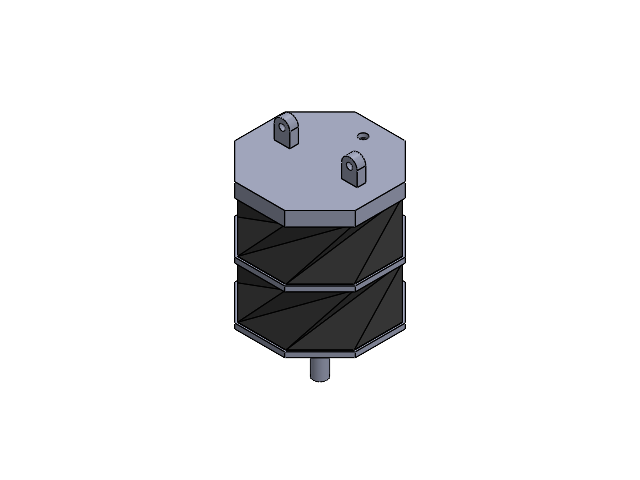
[picture p64: CAD file, 2024-12-23]
actuator_modeling/opposite_direction/Opposite_direction_DKRA.SLDASM
new_bottom
new_outer_kresling_cw x 2
new_inner_kresling_cw x 2
new_outer_link
new_inner_link
new_inner_top
new_outer_top
bearing
