ChooDH/DKRoA/(list of files, cad)

Other CAD files:
kresling_test/kresling test/test_stl/n_test/degree_test_top_n_10.STL
actuator_modeling/mechanical_seal/bottom.SLDPRT
kresling_test/kresling test/degree_n_test.SLDPRT
kresling_test/kresling test/test_stl/degree_test_top.STL
actuator_modeling/mechanical_seal/inner_link_mechanical_seal.SLDPRT
actuator_modeling/opposite_direction/outer_link_opposite_direction.SLDPRT
kresling_test/kresling test/degree_test_top_2.SLDPRT
kresling_test/kresling test/test_stl/n_test/degree_test_top_n_16.STL
actuator_modeling/mechanical_seal/outer_link_mechanical_seal.SLDPRT
kresling_test/kresling test/degree_test_2.SLDPRT
kresling_test/kresling test/test_stl/mode_test/kresling_mode_2_R_25_d_1.STL
actuator_modeling/opposite_direction/inner_link_opposite_direction.SLDPRT
kresling_test/kresling test/degree_test.SLDPRT
kresling_test/kresling test/test_stl/n_test/degree_test_n_6.STL
actuator_modeling/mechanical_seal/outer_kresling_cw.SLDPRT
kresling_test/kresling test/kresling_n_10.SLDPRT
kresling_test/kresling test/test_stl/mode_test/kresling_mode_2_R_30.STL
kresling_test/kresling test/test_stl/n_test/degree_test_top_n_14.STL
actuator_modeling/mechanical_seal/inner_kresling_cw.SLDPRT
kresling_test/kresling test/kresling_n_6.SLDPRT
kresling_test/kresling test/test_stl/mode_test/kresling_mode_2_R_35.STL
kresling_test/kresling test/test_stl/n_test/degree_test_n_12.STL
kresling_test/kresling test/kresling_n__12_mode_3.SLDPRT
kresling_test/kresling test/test_stl/mode_test/kresling_n__12_mode_4.STL
kresling_test/kresling test/test_stl/n_test/kresling_n_16.STL
kresling_test/kresling test/kresling_n_14.SLDPRT
kresling_test/kresling test/test_stl/n_test/degree_test_top_n_12.STL
kresling_test/kresling test/kresling_n__12_mode_2.SLDPRT
kresling_test/kresling test/test_stl/n_test/degree_test_n_14.STL
kresling_test/kresling test/degree_n_test_top.SLDPRT
kresling_test/kresling test/test_stl/n_test/degree_test_n_16.STL
kresling_test/kresling test/test_stl/n_test/kresling_n_12.STL
