ChooDH/DKRoA/연구자료/kresling_Angle_Test.xlsx

n | h_1 | mode | thick | D | experimental_angle(°) | theoretical_angle(°) | theoretical_angle_h_actual(°) | alpha | h_theoretical | h_actual
8 | 25 | 1 | 0.6 | 30 | 73 | 90 | 90 | 0.9182 | 5 | 5.1
8 | 25 | 1 | 0.6 | 35 | 53 | 78.4 | 76.39 | 0.9561 | 5 | 5.45
8 | 25 | 1 | 0.6 | 40 | 45 | 48.59 | 48.39 | 0.9885 | 5 | 5.18
8 | 25 | 1 | 0.6 | 45 | 34 | 36.34 | 36.15 | 0.9904 | 5 | 5.26
8 | 25 | 1 | 0.6 | 50 | 27 | 28.68 | 28.5 | 0.9922 | 5 | 5.33
8 | 25 | 1 | 0.6 | 55 | 22 | 23.37 | 23.15 | 0.9934 | 5 | 5.51
8 | 25 | 1 | 0.6 | 60 | 18.5 | 19.47 | 19.27 | 0.9952 | 5 | 5.54
8 | 25 | 1 | 0.6 | 65 | 16 | 16.5 | 16.36 | 0.9977 | 5 | 5.48
8 | 25 | 1 | 0.6 | 70 | 14 | 14.17 | 14.06 | 0.9995 | 5 | 5.45
n | h_1 | mode | thick | D | experimental_angle(°) | theoretical_angle(°) | theoretical_angle_h_actual(°) | alpha | h_theoretical | h_actual
8 | 25 | 2 | 0.6 | 30 | 66 | Nan | Nan | 0.8003 | 5 | 4.73
8 | 25 | 2 | 0.6 | 40 | 40.5 | Nan | Nan | 0.9024 | 5 | 4.88
8 | 25 | 2 | 0.6 | 50 | 24.5 | Nan | Nan | 0.9415 | 5 | 4.98
n | h_1 | mode | thick | D | experimental_angle(°) | theoretical_angle(°) | theoretical_angle_h_actual(°) | alpha | h_theoretical | h_actual
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
